StephanVennens/Linefollower/bill of materials/Bomb.xlsx

BILL OF MATERIALS LINE READER
 | Stuk nr. | aantal | naam | Type | Kostprijs | Verzend | Weblink | Datasheet
BRON
 | 1 | 2 | Batterij | Tenpower INR18650-28HE 2800mAh - 10A | €6.00 | €4.70 | https://eu.nkon.nl/rechargeable/li-ion/18650-size/tenpower-inr18650-28he-2800mah-10a.html
 | 2 | 1 | Batterijhouder | 2x 18650 Batterijhouder met klemkontacten en losse draden | €1.75 | €4.70 | https://www.nkon.nl/accessories/battery-cases/18650/2x-18650-batterijhouder-met-losse-draden.html
 | 3 | 1 | Charger | Nitecore UM2 USB battery charger | €15.45 | €4.70 | https://www.nkon.nl/nitecore-intellicharger-ci2.html
H-brug
 | 4 | 2 | H-brug | DRV8835 | €12.80 | €4.34 | https://botland.store/drivers-for-dc-motors/851-drv8835-two-channel-motor-controller-11v-12a-pololu-2135-5904422367220.html | https://botland.store/index.php?controller=attachment&id_attachment=140
Motoren
 | 5 | 2 | Motor | 6V 50:1 metal DC motor | €21.38 | €2.50 | https://www.tinyosshop.com/index.php?route=product/product&limit=50&manufacturer_id=11&product_id=1123
 | 6 | 2 | wielen | 3D-print | €0.05 | €0.00
Commu
 | 7 | 1 | Bluetooth | Bluetooth HC-05 module RF transceiver Master en Slave | €6.99 | €4.99 | https://www.otronic.nl/a-65154703/communicatie/bluetooth-hc-05-module-rf-transceiver-master-en-slave/ | https://components101.com/sites/default/files/component_datasheet/HC-05%20Datasheet.pdf
µcontroll
 | 8 | 1 | controller | ATMEGA32u4 (Al in bezit) | €0.00 | €0.00
Sensoren
 | 9 | 1 | Sensoren array | QTR-8A | €11.91 | €4.34 | https://www.robotshop.com/be/nl/pololu-qtr-8a-reflectiesensor-array.html | https://www.robotshop.com/media/files/pdf/pololu-qtr-8x-reflectance-sensor-array-user-guide.pdf
Body
 | 10 | 1 | Printplaat | Testprint 50x100mm met halfdoorlopende banen | €1.15 | €0.00 | https://www.gotron.be/meten-solderen/solderen/printplaten/testprint-50x100mm-met-halfdoorlopende-banen.html
 | 11 |  | Soldeerbare pinnen
 | 12 | 1 | Schakelaar
 | 13 | 1 | Body | 3d-printed base
 | 14 | 1 | Bout | M3x40 met afgeronde kop
 | 15 | 1 | Drukknop
