StephanVennens/Linefollower/technische tekeningen/elektronisch/pcb planA.pdf

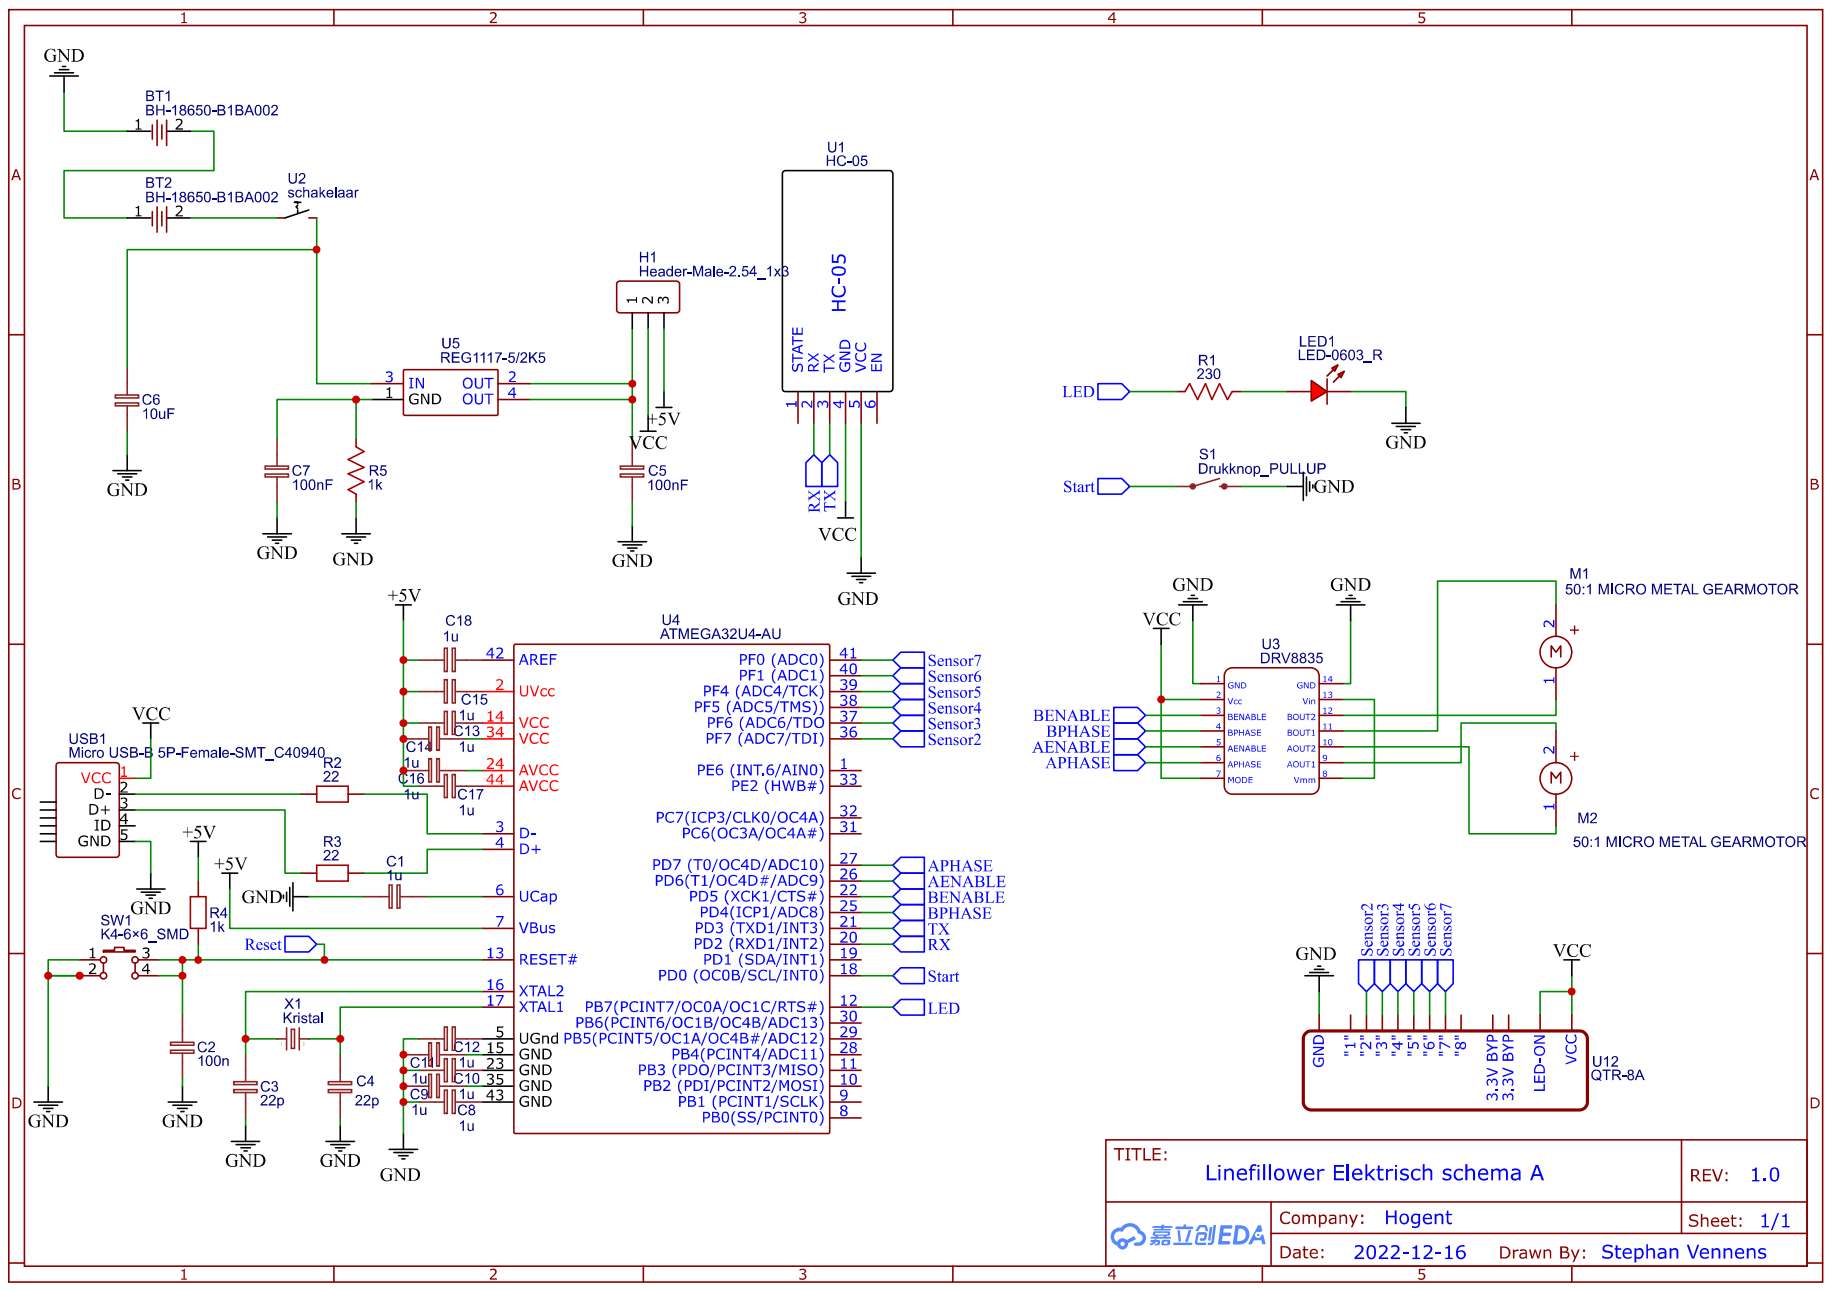
[picture p1: page 1]
