StephanVennens/Linefollower/technische tekeningen/elektronisch/SVsynthese-elekschema.pdf

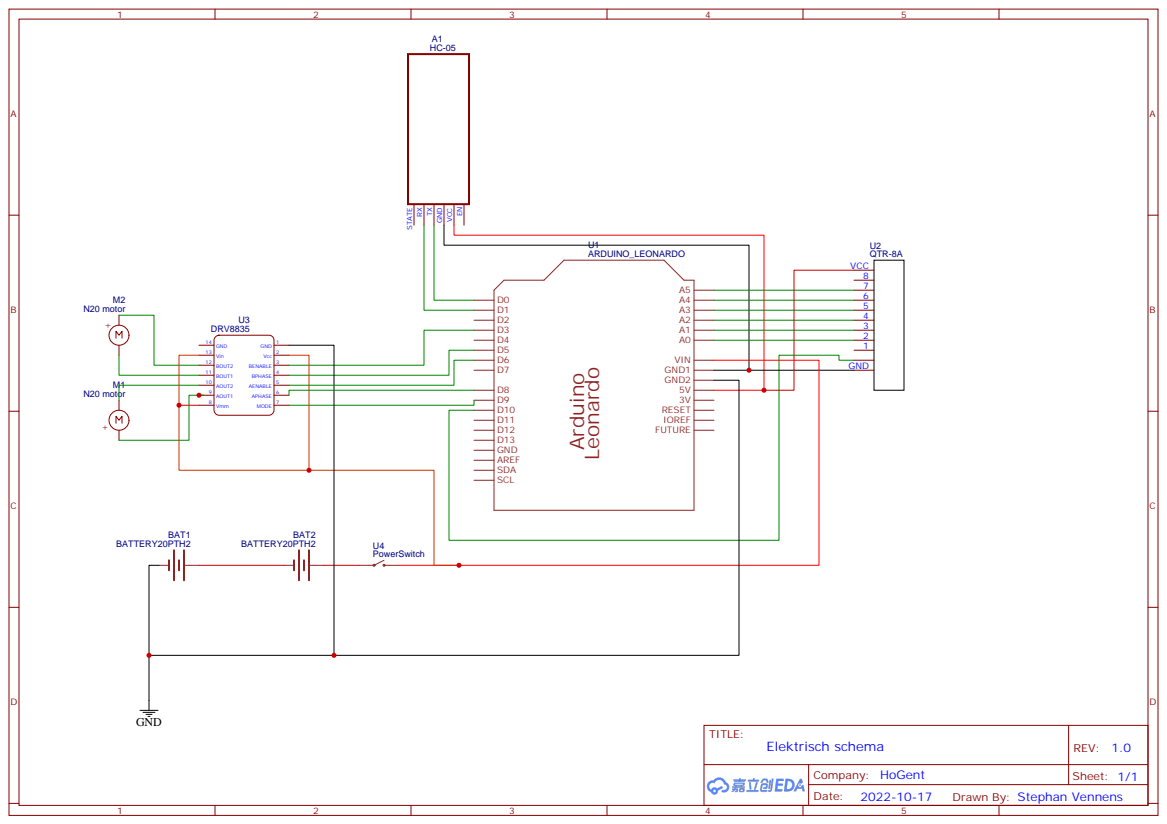
[picture p2: page 1]

Drawn By: Stephan Vennens
