StephanVennens/Linefollower/code/proof of concepts/sensor/Proof_of_concept_Sensor.ino

#include <QTRSensors.h> //QTR bibilotheek

QTRSensors qtr;

const uint8_t SensorCount = 6; // aantal sensoren die je gebruiky
uint16_t sensorValues[SensorCount];

void setup()
{
  // configure the sensors
  qtr.setTypeAnalog();
  qtr.setSensorPins((const uint8_t[]){A0, A1, A2, A3, A4, A5,}, SensorCount);
  qtr.setEmitterPin(13);

  Serial.begin(9600);
}


void loop()
{
  // read raw sensor values
  qtr.read(sensorValues);

  // print the sensor values as numbers from 0 to 1023, where 0 means maximum
  // reflectance and 1023 means minimum reflectance
  for (uint8_t i = 0; i < SensorCount; i++)
  {
    Serial.print(sensorValues[i]);
    Serial.print('\t');
  }
  Serial.println();

  delay(500);
}
